ciurescum/Gallileo/README.md

# Galileo

Build an automated watering system using the Intel Galileo Gen 2 Development Board. 

The purpose of this project is to water a plant based on the information provided by three sensors. It is developed on an Intel Galileo Gen 2 Dev Board and it uses Arduino IDE.

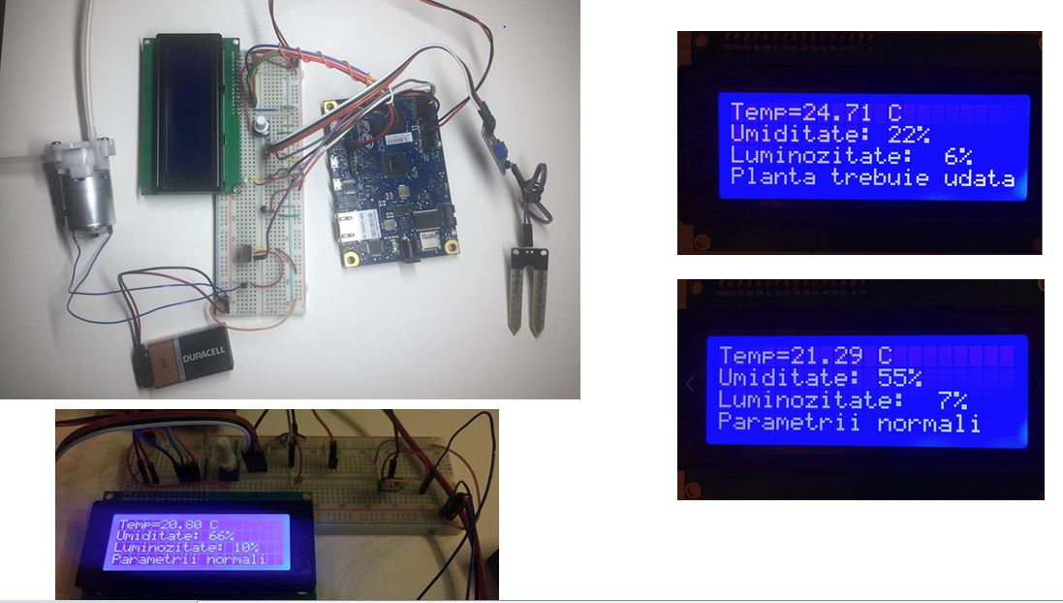
[picture p1: project.JPG]
Galileo
