ciurescum/Gallileo/schematic.JPG

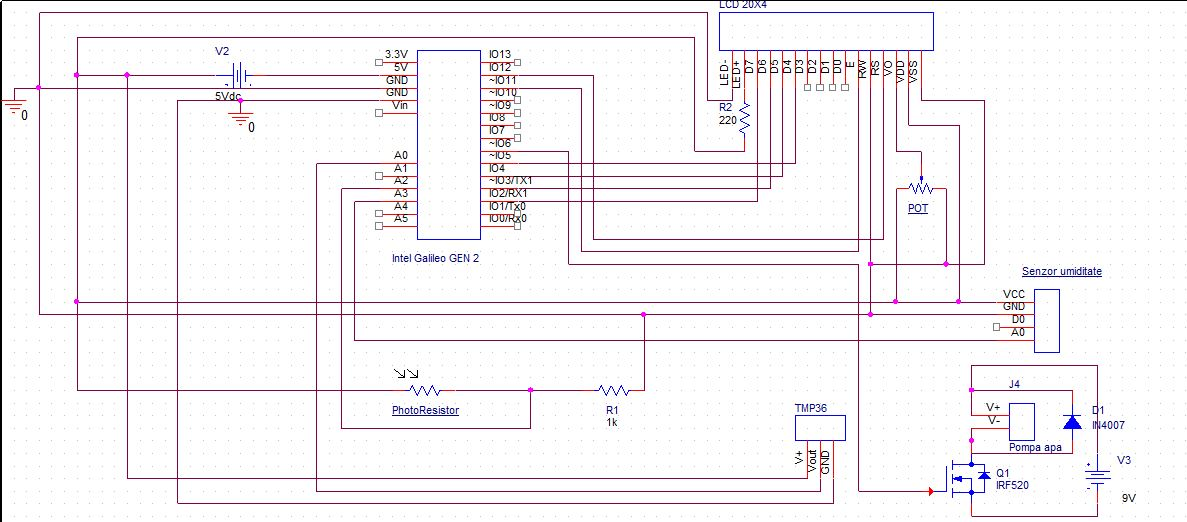
schematic.JPG
